DuverneyCM/DataGlove/guante_adxl_18062015/PLLJ_PLLSPE_INFO.txt

PLL_Name	spipll:u_spipll|altpll:altpll_component|spipll_altpll:auto_generated|pll1
PLLJITTER	30
PLLSPEmax	84
PLLSPEmin	-53
