DuverneyCM/DataGlove/(list of files, cad)

Other CAD files:
guante_adxl_18062015/DE0_NANO_GSensor_vhdl/stp1_auto_stripped.stp
